KZack/uStar/uStar/20171221uStar_sch_v2.0.pdf

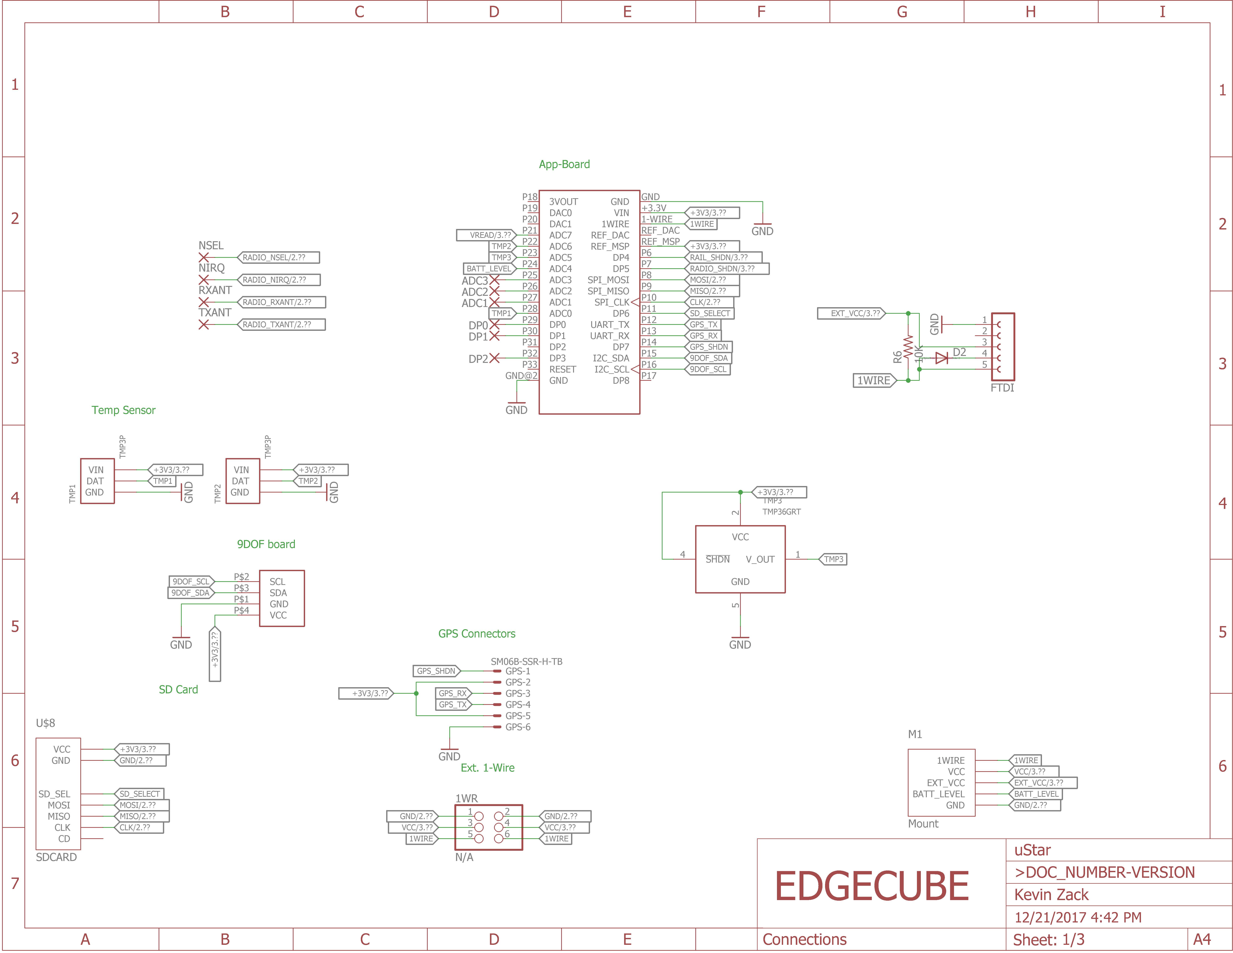
[picture p4: page 1]
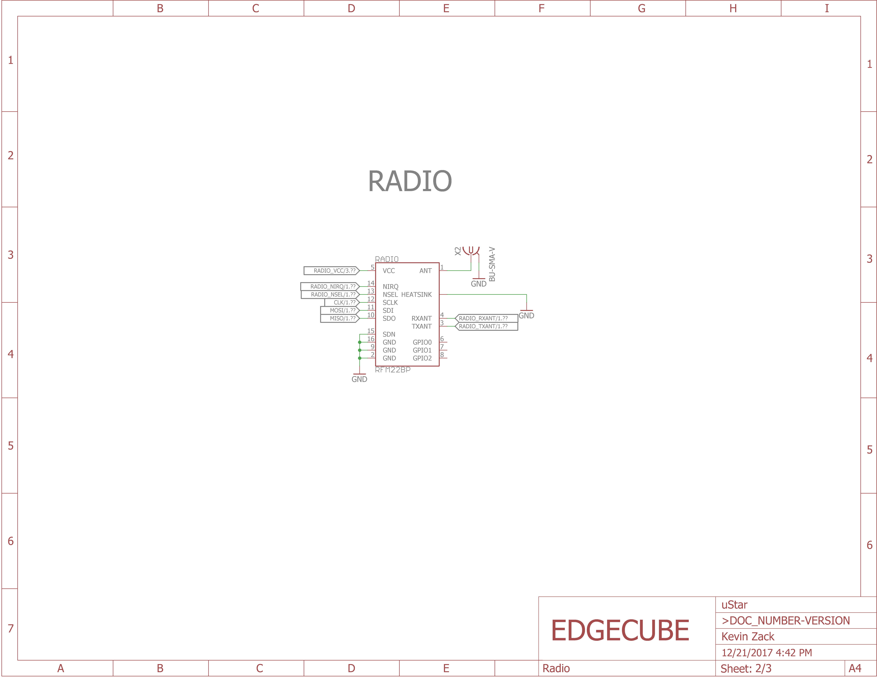
[picture p5: page 2]
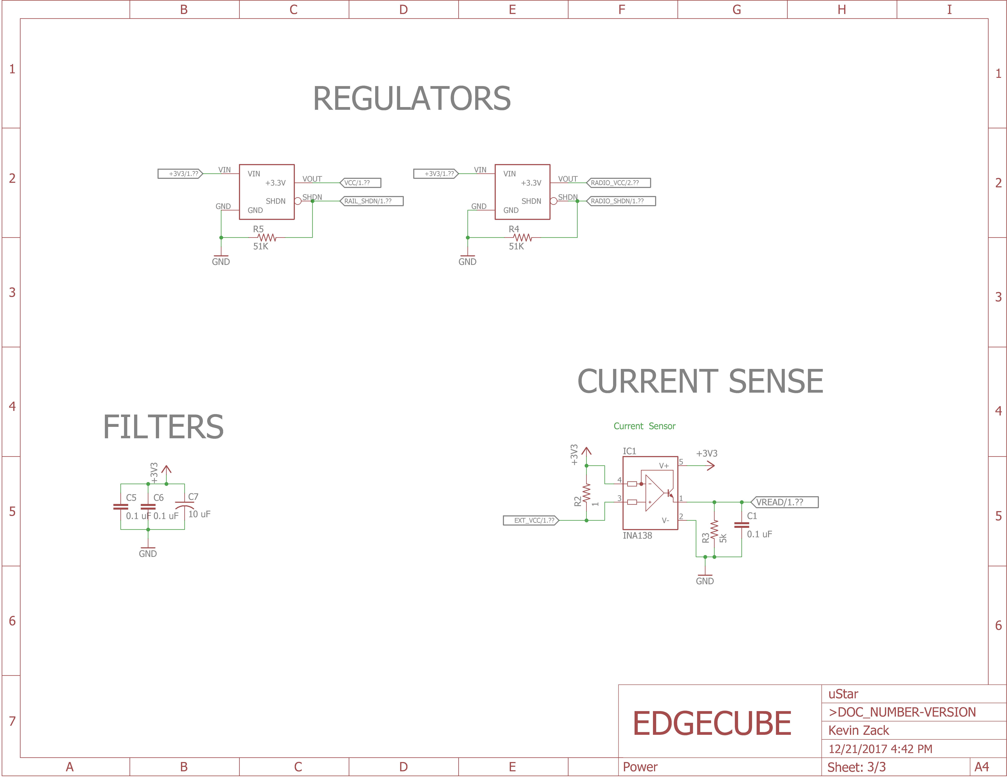
[picture p6: page 3]
