KZack/uStar/uStar/20171221_PartsList_v2_0.xlsx

Parts
Part | Value | Device | Package | Library | Link | Cost
IC1 | INA138 | INA138 | SOT23-5 | burr-brown | http://www.mouser.com/ProductDetail/Texas-Instruments/INA138NA-3K/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 | 1.72
X1 | BU-SMA-V | BU-SMA-V | BU-SMA-V | con-coax | http://www.mouser.com/ProductDetail/Amphenol/132134/?qs=b8dDPpdgesvQEpS4IQp3aA%3D%3D | 1.95
GPS | SM06B-SSR-H-TB | SM06B-SSR-H-TB | SM06B-SSR-H-TB | con-jst2 | http://www.digikey.com/product-search/en?keywords=SM06B-SSR-H-TB | 0.38
D1 | 1N4148DO35-7 | 1N4148DO35-7 | DO35-7 | diode | https://www.sparkfun.com/products/8588 | 0.15
U$4 | TMP_EXT | TMP_EXT | TMP_EXT | LearningByMaking | https://www.sparkfun.com/products/10988 | 1.5
U$5 | 9DOF | 9DOF | 9DOF | LearningByMaking | https://www.sparkfun.com/products/10724 | 49.95
U$6 | SDCARD_EXT | SDCARD_EXT | SDCARD_EXT | LearningByMaking | https://www.sparkfun.com/products/544 | 3.95
U$3 | S7V8F3_VOLT_REG-3V3_ | 1AHORZ-DOWN S7V8F3_VOLT_REG-3V3_1AHORZ-DOWN | S7V_DOWN | Pololu | https://www.pololu.com/product/2122 | 5.95
U$7 | S7V8F3_VOLT_REG-3V3_ | 1AHORZ-DOWN S7V8F3_VOLT_REG-3V3_1AHORZ-DOWN | S7V_DOWN | Pololu | https://www.pololu.com/product/2122 | 5.95
R4 | 50K | R-US_R0603 | R0603 | rcl | http://www.mouser.com/ProductDetail/Vishay-Thin-Film/PNM0603E5002BST1/ | 0.3
R5 | 50K | R-US_R0603 | R0603 | rcl | http://www.digikey.com/product-detail/en/vishay-thin-film/PLTT0603Z5002QGT5/764-1079-6-ND/4766179 | 0.3
C1 | 0.1uF | C-EUC0805 | C0805 | resistor | http://www.mouser.com/ProductDetail/Kemet/C0805C104K5RACTU/ | 0.1
C2 | 0.1uF | C-EUC0603 | C0603 | resistor | http://www.mouser.com/ProductDetail/Kemet/C0805C104K5RACTU/ | 0.1
C3 | 1uF | C-EUC0603 | C0603 | resistor | http://www.mouser.com/ProductDetail/AVX/08053G105ZAT2A/?qs=sGAEpiMZZMs0AnBnWHyRQKZcV7shucx0TmdHpQJmLKc%3d | 0.29
C4 | 10uF | CPOL-EUSMCB | SMC_B | resistor | http://www.mouser.com/ProductDetail/AVX/TAJT106K016YNJ/ | 0.28
R1 | 10k | R-US_0207/7 | 0207/7 | resistor | https://www.sparkfun.com/products/8374 | 0.25
R2 | 1 | R-US_R0603 | R0603 | resistor | http://www.mouser.com/ProductDetail/Panasonic/ERJ-3RQF1R0V/ | 0.29
R3 | 5k | R-US_R0603 | R0603 | resistor | http://www.mouser.com/ProductDetail/Vishay-Thin-Film/PNM0603E5001BST1/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 | 1.79
U$2 | RFM22SMD | RFM22SMD | RFM22-XXX-S2 | SparkFun-RF | https://www.sparkfun.com/products/10154 | 22.95
FTDI | FTDI-5PIN | FTDI-5PIN | 1X05 | FTDI | https://www.sparkfun.com/products/116 | 0.1875
NA | Daisy Chain Jumpers | Jumper Pins | Jumper Pins | Pin | http://www.mouser.com/Search/ProductDetail.aspx | 0.54
U$1 | Left Side | App-Board 1.2/1.3 | pin | LbyM | http://www.mouser.com/Search/ProductDetail.aspx | 2.58
U$1 | Right Side | App-Board 1.2/1.3 | pin | LbyM | http://www.mouser.com/Search/ProductDetail.aspx | 2.58
 |  |  |  |  | Total | 104.0375
FTDI | FTDI-5PIN | FTDI-5PIN | 1_05X2MM | FTDI
