KZack/uStar/uStar/20171221_uStar_layout_v2.0.pdf

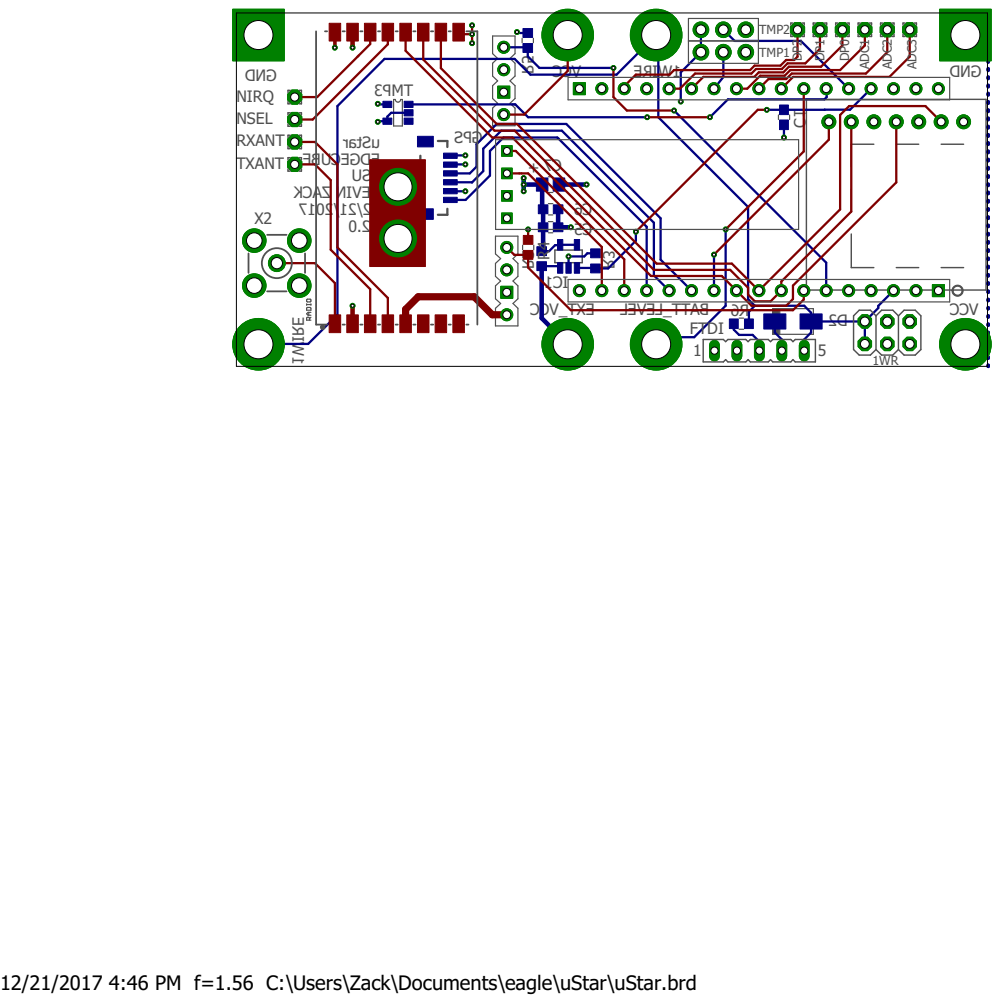
[picture p7: page 1]

12/21/2017 4:46 PM f=1.56 C:\Users\Zack\Documents\eagle\uStar\uStar.brd

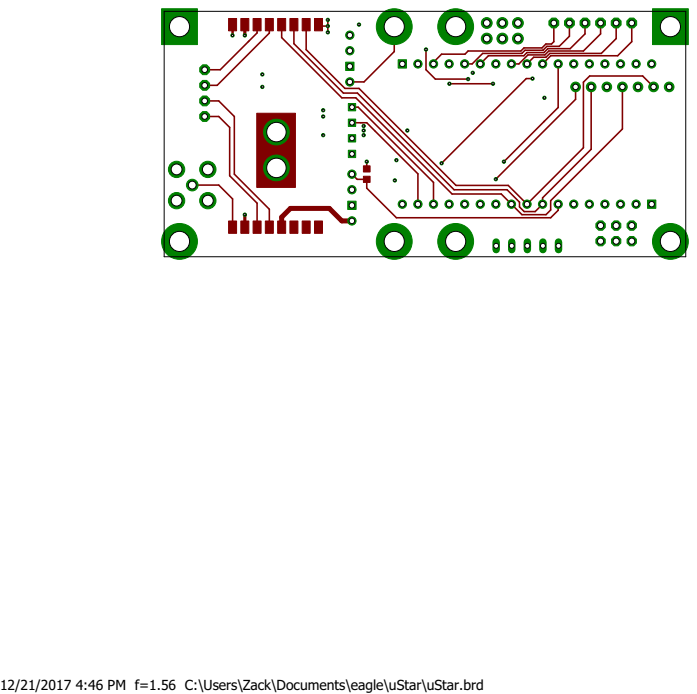
[picture p8: page 2]

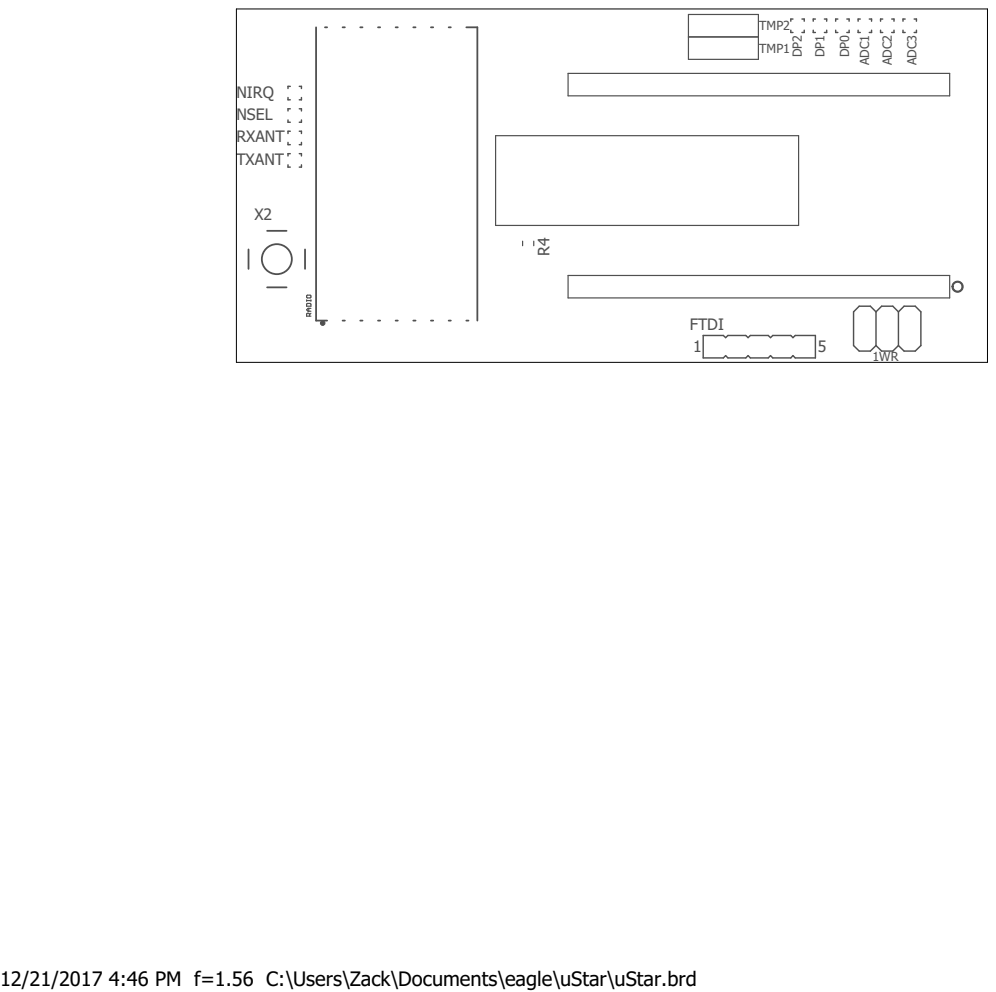
[picture p9: page 3]

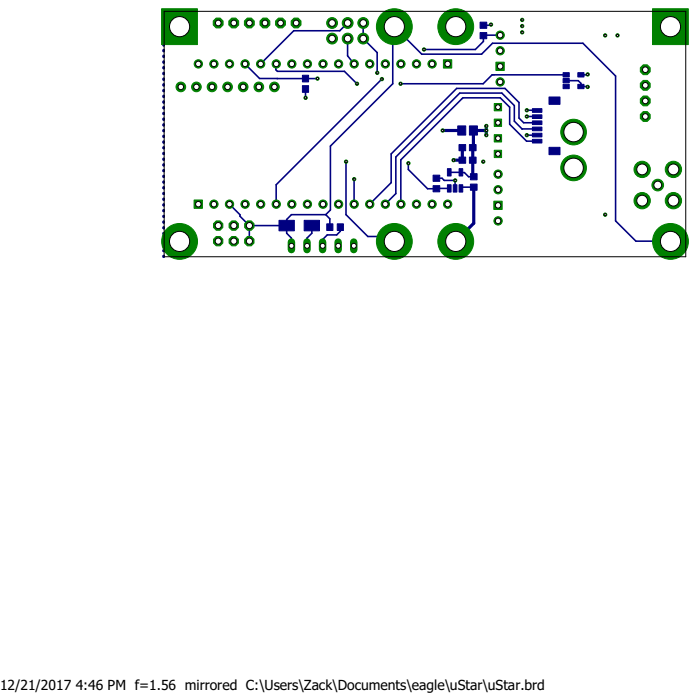
[picture p10: page 4]

12/21/2017 4:46 PM f=1.56 mirrored C:\Users\Zack\Documents\eagle\uStar\uStar.brd

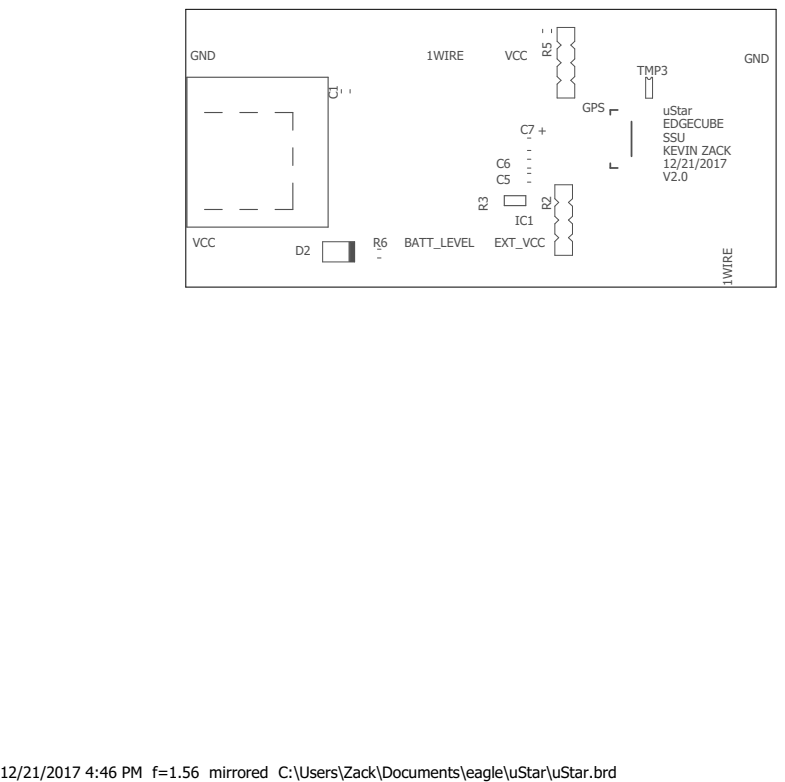
[picture p11: page 5]
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
