KZack/uStar/uStar/uStar_bot.pdf

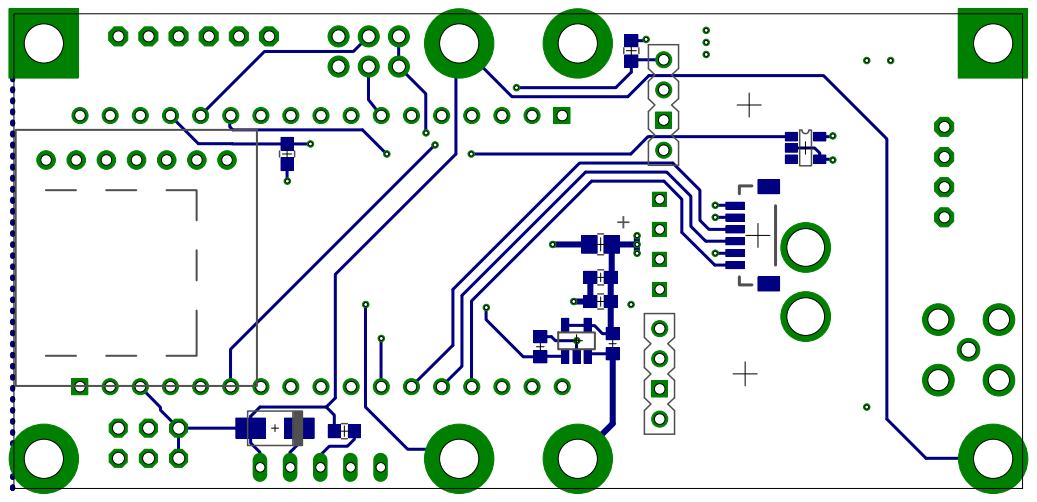
[picture p12: page 1]
