KZack/uStar/uStar/uStar_top.pdf

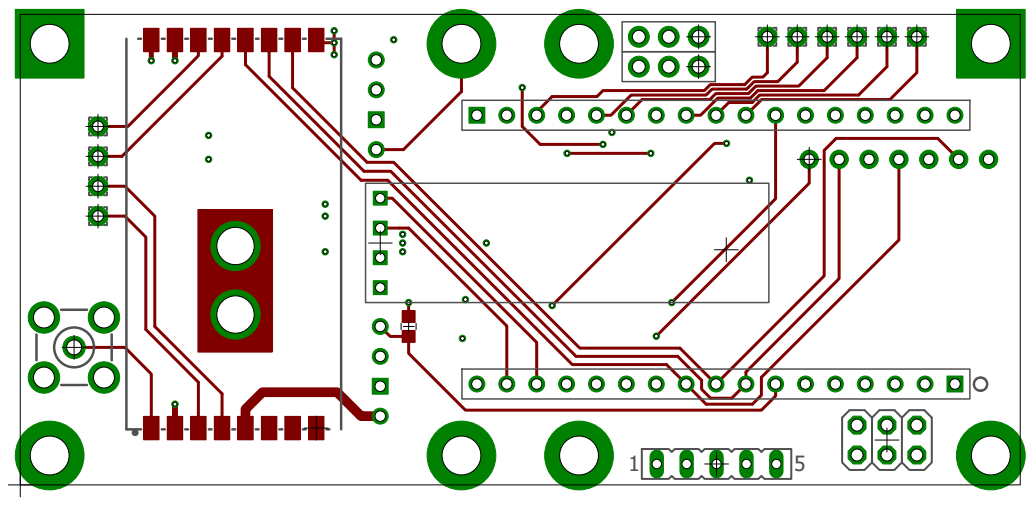
[picture p13: page 1]
