KZack/uStar/uStar/uStar.brd

## EAGLE design uStar/uStar.brd (2018-01-04)

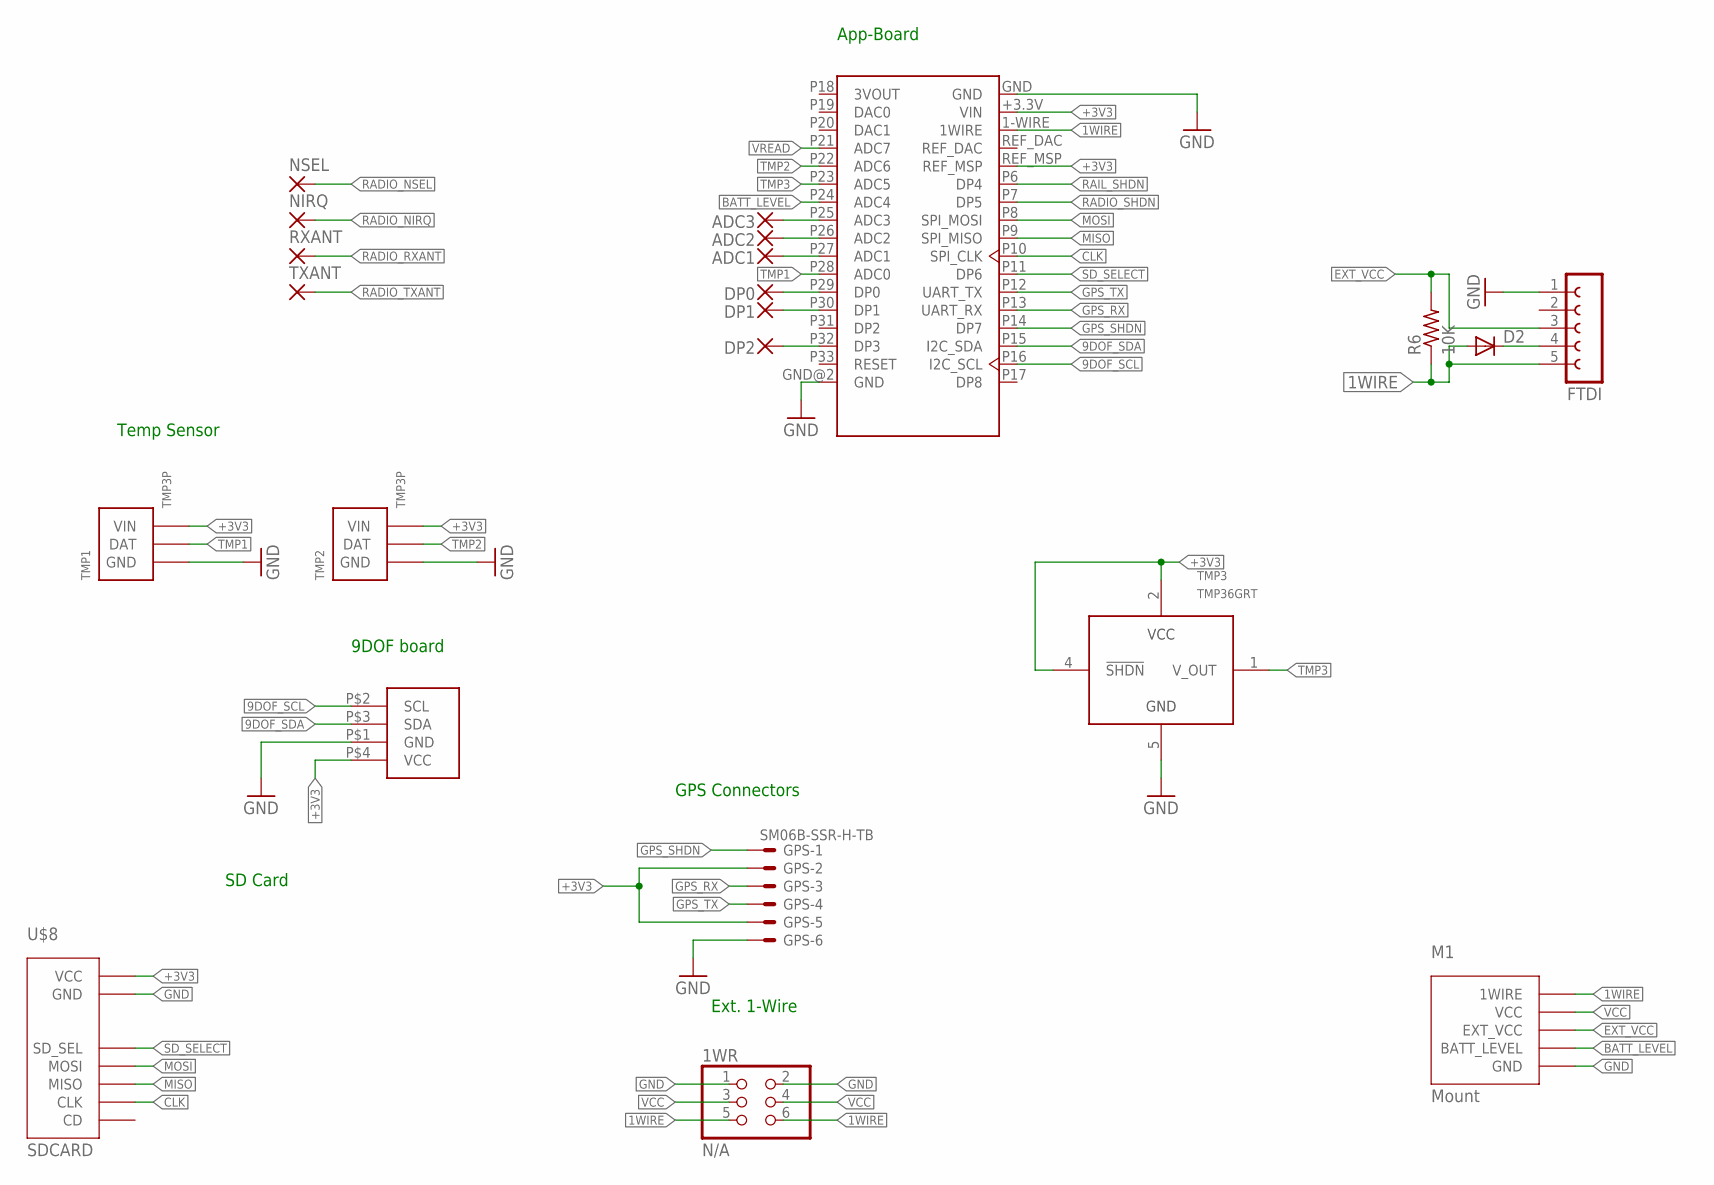
[picture p14: schematic uStar.sch, sheet 1, Connections]

Parts:
1WR: N/A; 2X03
ADC1, ADC2, ADC3: 1,6/0,9
D2: D-B260A; SMA-DO214AC
DP0, DP1, DP2: 1,6/0,9
FTDI: FE05-1
GPS: SM06B-SSR-H-TB
M1: Mount; 4X8MOUNT
NIRQ: 1,6/0,9
NSEL: 1,6/0,9
R6: 10K; R0603
RXANT: 1,6/0,9
TMP1, TMP2: TMP3P
TMP3: TMP36GRT; SOT-23-5
TXANT: 1,6/0,9
U$1: App-Board 1.2/1.3; APPCORE_RECEIVER
U$5: 9DOF
U$8: SDCARD

Connections:
1WIRE: 1WR.5, 1WR.6, D2.A, FTDI.5, M1.P$2 (1WIRE), M1.P$5 (1WIRE), R6.1, U$1.1-WIRE (1WIRE)
9DOF_SCL: U$1.P16 (I2C_SCL), U$5.P$2 (SCL)
9DOF_SDA: U$1.P15 (I2C_SDA), U$5.P$3 (SDA)
+3V3: GPS.2, GPS.5, TMP1.P$3 (VIN), TMP2.P$3 (VIN), TMP3.2 (VCC), TMP3.4 (!SHDN), U$1.+3.3V (VIN), U$1.REF_MSP, U$5.P$4 (VCC), U$8.P$3 (VCC); also elsewhere on the board
BATT_LEVEL: M1.P$6 (BATT_LEVEL), U$1.P24 (ADC4)
CLK: U$1.P10 (SPI_CLK), U$8.P$4 (CLK); also elsewhere on the board
EXT_VCC: FTDI.3, M1.P$3 (EXT_VCC), R6.2; also elsewhere on the board
GND: 1WR.1, 1WR.2, FTDI.1, GPS.6, M1.P$1 (GND), M1.P$8 (GND), TMP1.P$1 (GND), TMP2.P$1 (GND), TMP3.5 (GND), U$1.GND, U$1.GND@2 (GND), U$5.P$1 (GND), U$8.P$5 (GND); also elsewhere on the board
GPS_RX: GPS.3, U$1.P13 (UART_RX)
GPS_SHDN: GPS.1, U$1.P14 (DP7)
GPS_TX: GPS.4, U$1.P12 (UART_TX)
MISO: U$1.P9 (SPI_MISO), U$8.P$6 (MISO); also elsewhere on the board
MOSI: U$1.P8 (SPI_MOSI), U$8.P$2 (MOSI); also elsewhere on the board
unnamed: D2.K (C), FTDI.4
unnamed: ADC1.1, U$1.P27 (ADC1)
unnamed: ADC2.1, U$1.P26 (ADC2)
unnamed: ADC3.1, U$1.P25 (ADC3)
unnamed: DP0.1, U$1.P29 (DP0)
unnamed: DP1.1, U$1.P30 (DP1)
unnamed: DP2.1, U$1.P32 (DP3)
RADIO_NIRQ: NIRQ.1; also elsewhere on the board
RADIO_NSEL: NSEL.1; also elsewhere on the board
RADIO_RXANT: RXANT.1; also elsewhere on the board
RADIO_SHDN: U$1.P7 (DP5); also elsewhere on the board
RADIO_TXANT: TXANT.1; also elsewhere on the board
RAIL_SHDN: U$1.P6 (DP4); also elsewhere on the board
SD_SELECT: U$1.P11 (DP6), U$8.P$1 (SD_SEL)
TMP1: TMP1.P$2 (DAT), U$1.P28 (ADC0)
TMP2: TMP2.P$2 (DAT), U$1.P22 (ADC6)
TMP3: TMP3.1 (V_OUT), U$1.P23 (ADC5)
VCC: 1WR.3, 1WR.4, M1.P$4 (VCC), M1.P$7 (VCC); also elsewhere on the board
VREAD: U$1.P21 (ADC7); also elsewhere on the board

Notes on the sheet:
Ext. 1-Wire
App-Board
Temp Sensor
9DOF board
GPS Connectors
SD Card

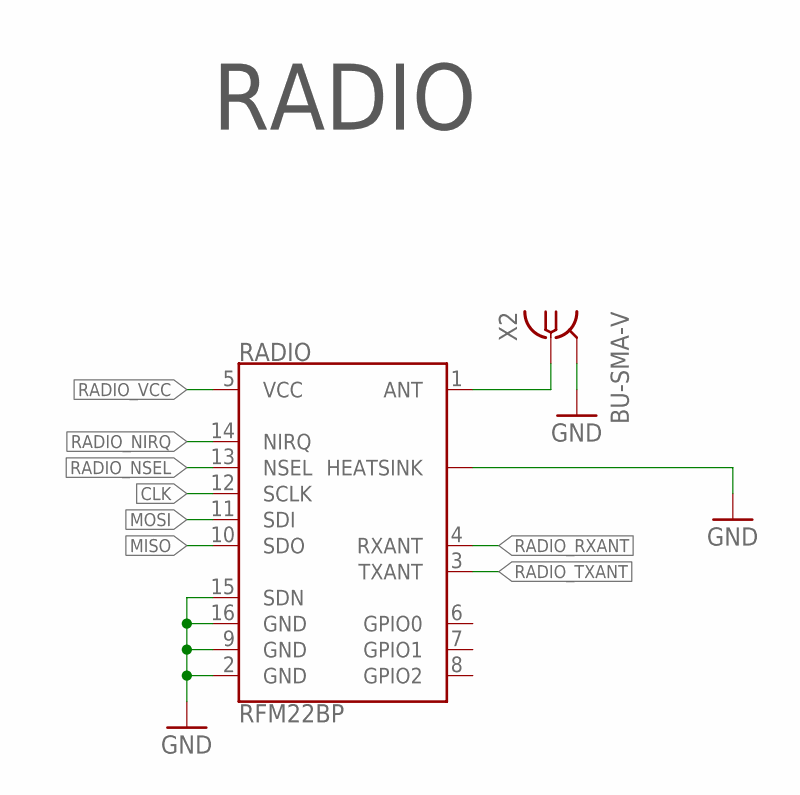
[picture p15: schematic uStar.sch, sheet 2, Radio]

Parts:
RADIO: RFM22BP
X2: BU-SMA-V

Connections:
ANT: RADIO.1 (ANT), X2.1
CLK: RADIO.12 (SCLK); also elsewhere on the board
GND: RADIO.2 (GND), RADIO.9 (GND), RADIO.15 (SDN), RADIO.16 (GND), RADIO.P$1 (HEATSINK), X2.2, X2.3 (2), X2.4 (2), X2.5 (2); also elsewhere on the board
MISO: RADIO.10 (SDO); also elsewhere on the board
MOSI: RADIO.11 (SDI); also elsewhere on the board
RADIO_NIRQ: RADIO.14 (NIRQ); also elsewhere on the board
RADIO_NSEL: RADIO.13 (NSEL); also elsewhere on the board
RADIO_RXANT: RADIO.4 (RXANT); also elsewhere on the board
RADIO_TXANT: RADIO.3 (TXANT); also elsewhere on the board
RADIO_VCC: RADIO.5 (VCC); also elsewhere on the board

Notes on the sheet:
RADIO

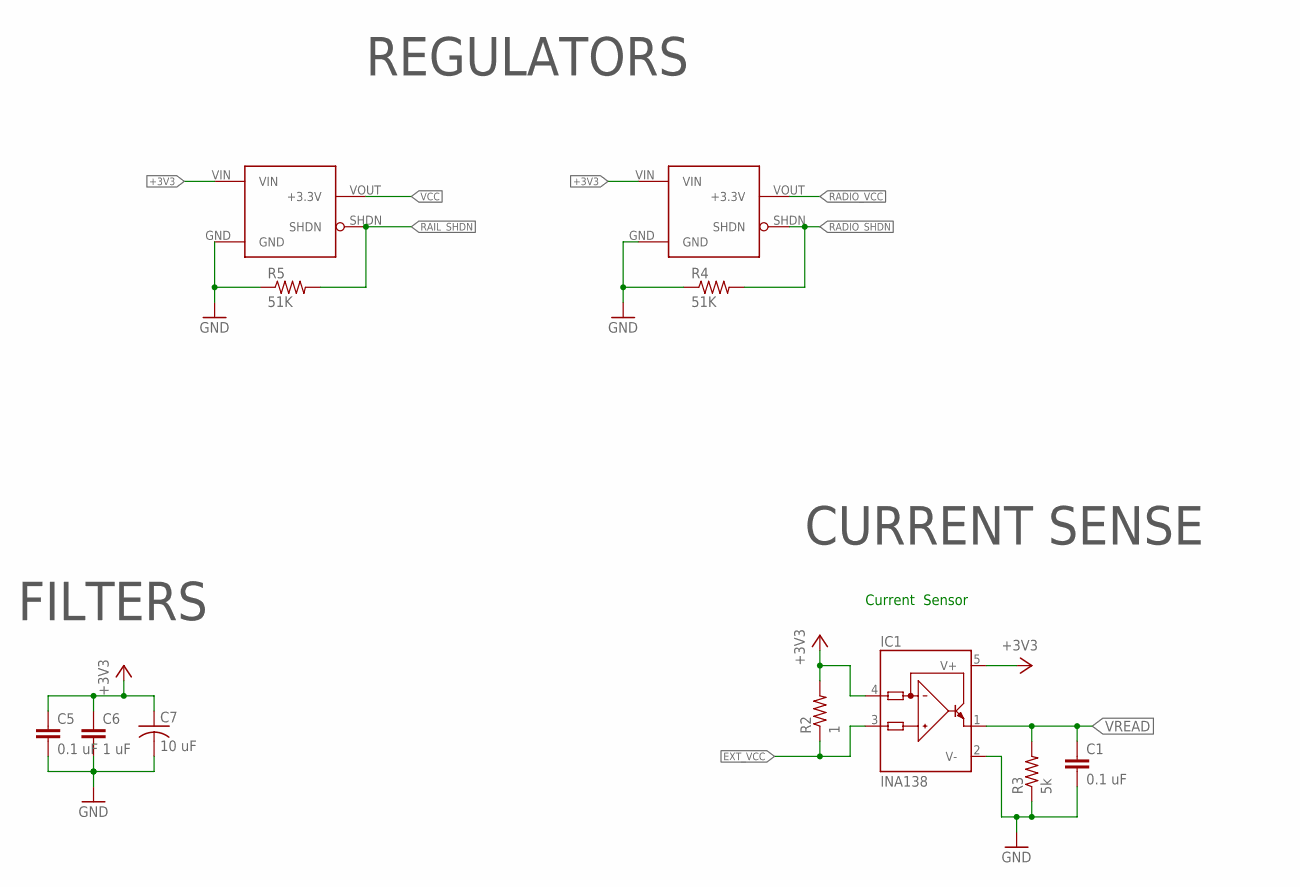
[picture p16: schematic uStar.sch, sheet 3, Power]

Parts:
C1, C5: 0.1 uF; C0603
C6: 1 uF; C0603
C7: 10 uF; C0805_POL
IC1: INA138; SOT23-5
R2: 1; R0603
R3: 5k; R0603
R4, R5: 51K; R0603
U$3, U$7: S7V8F3_VOLT_REG-3V3_1AHORZ-DOWN; S7V_DOWN

Connections:
+3V3: C5.1, C6.1, C7.2 (1), IC1.4 (IN-), IC1.5 (V+), R2.2, U$3.VIN, U$7.VIN; also elsewhere on the board
EXT_VCC: IC1.3 (IN+), R2.1; also elsewhere on the board
GND: C1.2, C5.2, C6.2, C7.1 (2), IC1.2 (V-), R3.1, R4.1, R5.1, U$3.GND, U$7.GND; also elsewhere on the board
RADIO_SHDN: R4.2, U$7.SHDN; also elsewhere on the board
RADIO_VCC: U$7.VOUT (+3.3V); also elsewhere on the board
RAIL_SHDN: R5.2, U$3.SHDN; also elsewhere on the board
VCC: U$3.VOUT (+3.3V); also elsewhere on the board
VREAD: C1.1, IC1.1 (OUT), R3.2; also elsewhere on the board

Notes on the sheet:
Current Sensor
REGULATORS
CURRENT SENSE
FILTERS

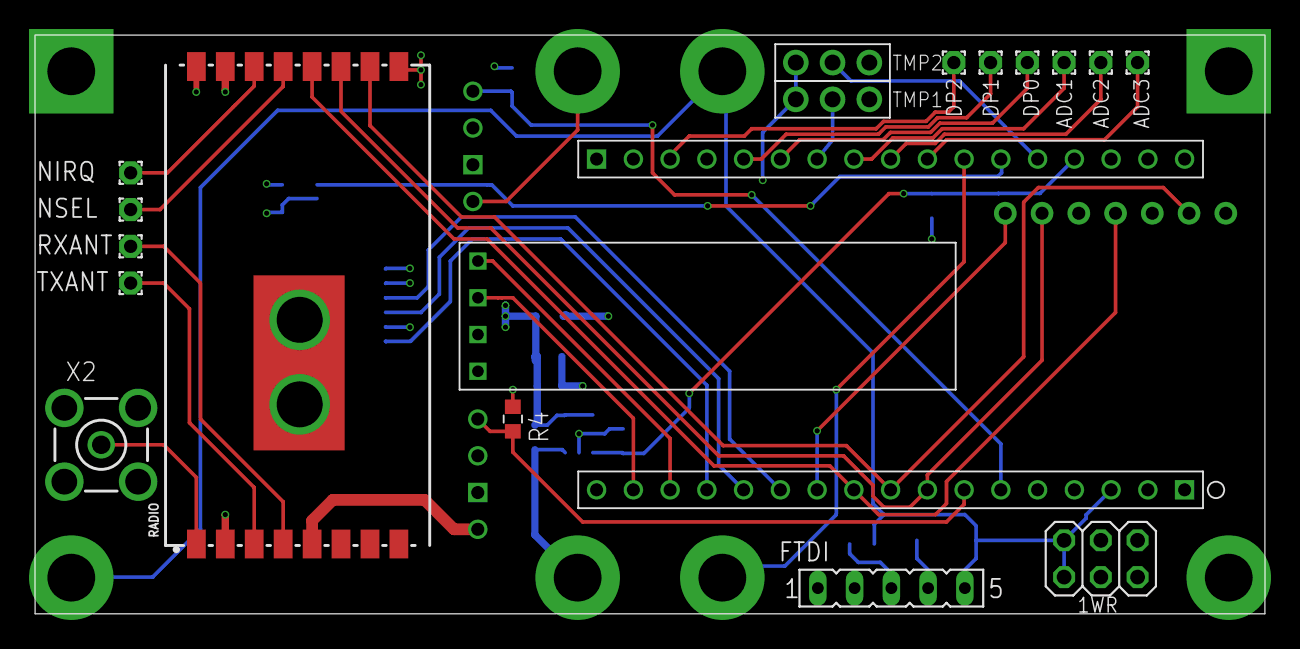
[picture p17: board uStar.brd from above]

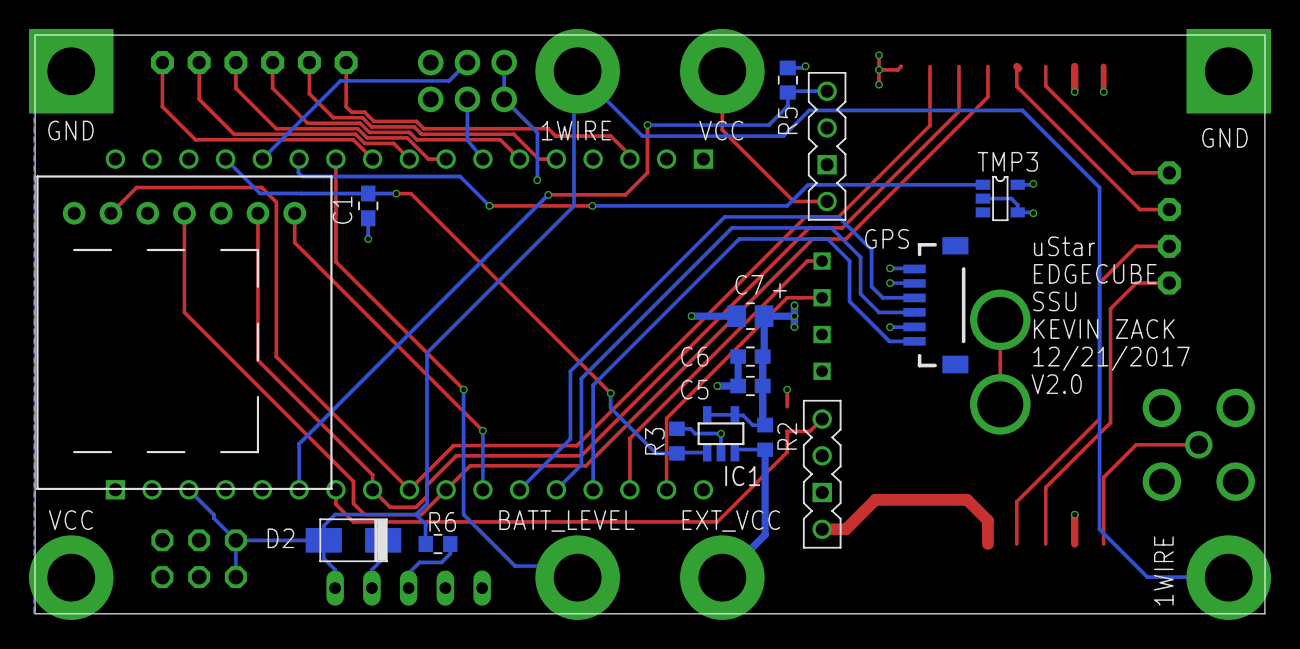
[picture p18: board uStar.brd from below]

Board: 4 copper layers, 85.0 x 40.0 mm, 35 parts (14 on the bottom side), 34 nets.
